Kimjw2024/2026ESWContest_free_AEGIS/docs/DATASET.md

# Dataset & Curation

## 1. Raw Archive vs Curated Training Data

The project uses two different scale descriptions, and they must not be mixed.

### Raw Working Archive

Recorded in the competition deck:

- approximately **13 GB**
- **156,416 files**
- **33 folders**
- approximately **40K candidate images**

This includes source images, labels, intermediate exports, logs, model artifacts and backup material.

### Curated Valid Paired Images

| Class / Group | Valid paired images |
|---|---:|
| crow | 1,674 |
| duck | 1,588 |
| egret | 2,125 |
| gull | 2,288 |
| pigeon | 1,294 |
| raptor | 1,481 |
| sparrow | 1,379 |
| swallow | 1,341 |
| **Total** | **13,170** |

`raptor` is a bird group rather than a single biological species; the correct wording is **8-class bird classification / 8개 조류군 분류**.

## 2. Curation Pipeline

```text
source image/label pairing
→ class-wise candidate review
→ duplicate / low-resolution / blur removal
→ non-bird / wrong-class exclusion
→ missing-label audit
→ manual exclusion rules
→ Raspberry Pi field-background hard negatives
→ detector split and classifier crop split
→ training / validation / held-out test
```

- Raspberry Pi field-background negatives: **518**
- Final prepared YOLO v2: **12,819 images**
- Held-out test: **1,325 images / 1,436 bird instances / 67 backgrounds**

<p align="center">class-wise dataset candidate review</p>

## 3. Detector and Classifier Data Separation

### YOLO

- full image
- bird bbox label
- background / hard-negative image
- objective: localization center for 3D tracking

### ResNet-18

- detector-derived or curated object crop
- one of 8 class/group labels
- objective: species/group evidence for risk assessment

The detector and classifier are related but do not use an identical sample representation.

## 4. Reproducibility

- preparation: `training/prepare_aegis_bird_data.py`
- audit: `training/audit_yolo_missing_birds_v2.py`
- clean build: `training/build_clean_yolo_v2.py`
- visual inspection: `training/inspect_prepared_samples.py`
- manual rules: `training/audit_rules.json`

The raw corpus is not committed because of size and source-management constraints. The repository preserves code, class definitions, summary counts, final metrics and representative evidence.

## 5. Source Provenance & Redistribution Control

The public contest repository **does not redistribute the 13 GB raw image corpus**.

For every external source batch, the team must retain an internal source ledger containing:

| Required field | Purpose |
|---|---|
| Provider / dataset name | identify the original source |
| Source URL or archive ID | trace the exact batch |
| Acquisition date | preserve version context |
| License / terms of use | verify training and redistribution conditions |
| Redistribution allowed? | decide whether raw images may be published |
| Local batch / class mapping | connect source records to curated outputs |
| Team edits | record relabeling, crop, exclusion and hard-negative processing |

Public repository 관리 원칙:

- non-self-captured external batch는 source와 usage condition을 확인 대상으로 관리한다
- do not upload raw images whose redistribution permission is unclear
- keep source-specific records in the Master Archive if they contain local paths or non-public acquisition metadata
- cite public datasets/providers in the report or repository when their terms require attribution

공개 저장소에는 재현 코드·정제 규칙·집계 결과와 대표 evidence를 제공하고, 원천별 상세 기록은 재배포 조건과 로컬 경로 노출을 고려해 별도 관리한다.

## 6. Validation Scope

The dataset is a research/competition prototype and does not fully represent every airport, weather, altitude, sensor and background distribution. Offline metrics must not be presented as certified field performance.
