Kimjw2024/2026ESWContest_free_AEGIS/assets/ai_console/decision_console.png

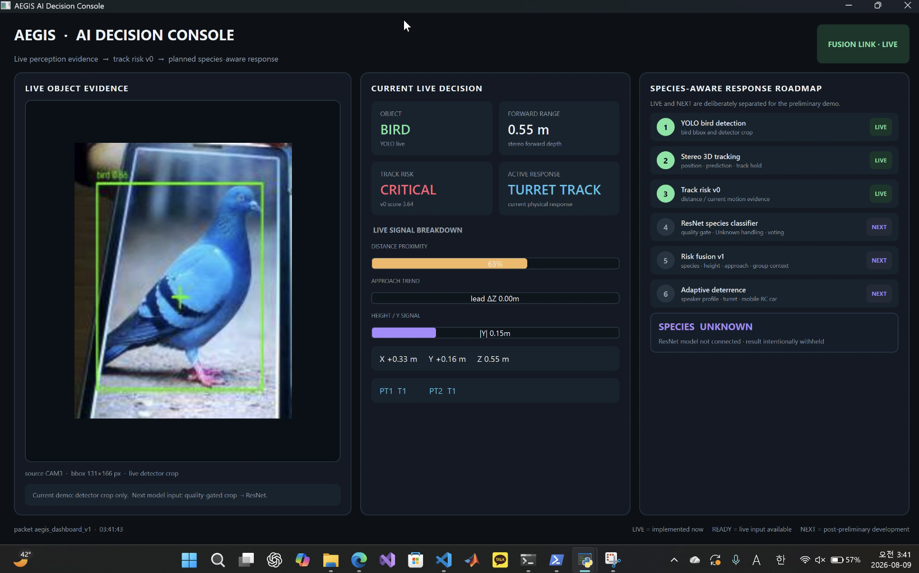
assets/ai_console/decision_console.png
