Kimjw2024/2026ESWContest_free_AEGIS/assets/dataset/dataset_management.png

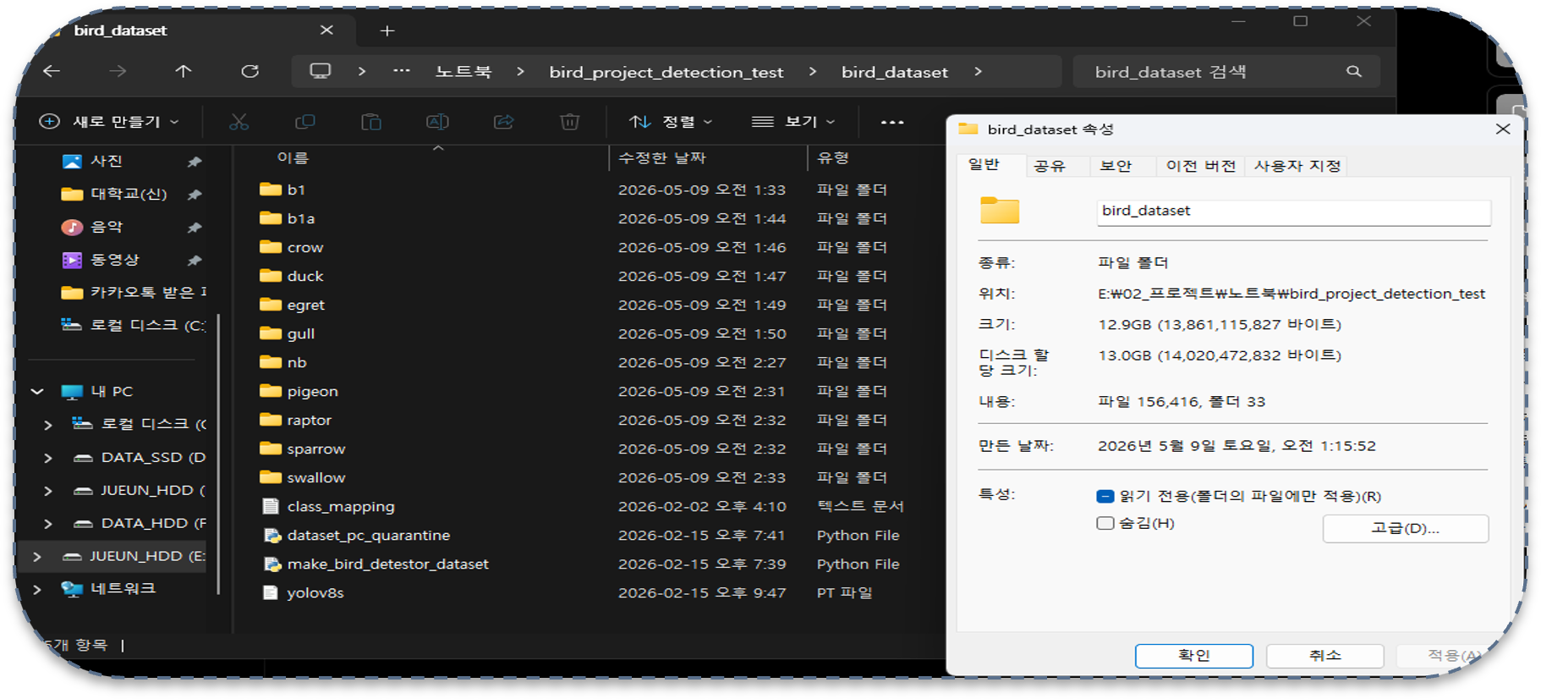
assets/dataset/dataset_management.png
