Kimjw2024/2026ESWContest_free_AEGIS/assets/system/hsv_baseline.png

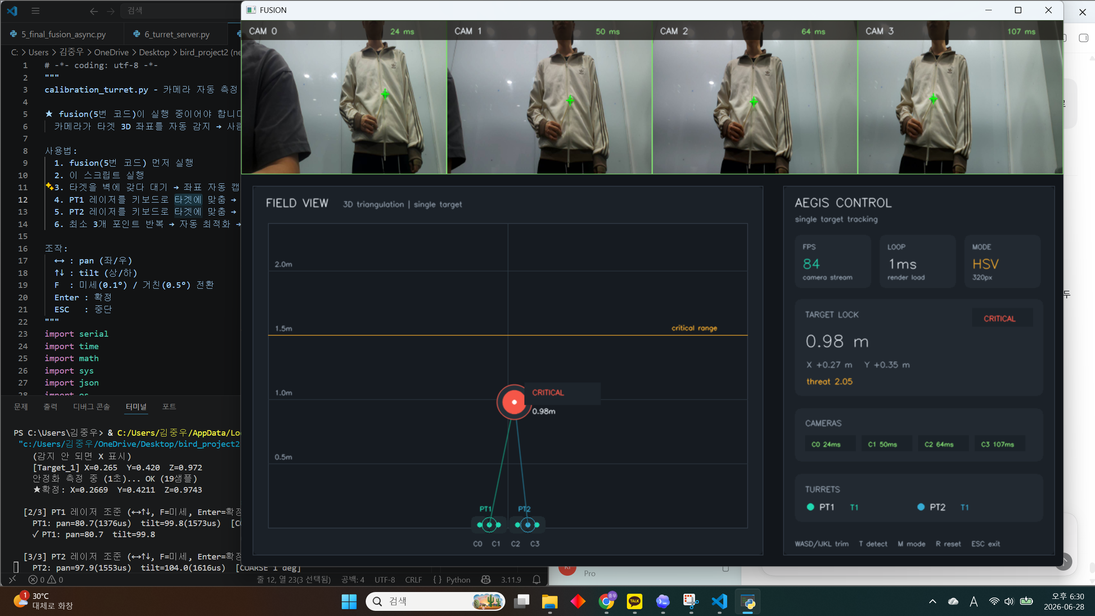
assets/system/hsv_baseline.png
