Kimjw2024/2026ESWContest_free_AEGIS/results/yolo/results.csv

epoch | time | train/box_loss | train/cls_loss | train/dfl_loss | metrics/precision(B) | metrics/recall(B) | metrics/mAP50(B) | metrics/mAP50-95(B) | val/box_loss | val/cls_loss | val/dfl_loss | lr/pg0 | lr/pg1 | lr/pg2
1 | 1414.18 | 1.61483 | 1.60596 | 1.93497 | 0.66806 | 0.63314 | 0.67292 | 0.31463 | 1.66369 | 2.003 | 2.14464 | 0.000666406 | 0.000666406 | 0.000666406
2 | 2832.3 | 1.55933 | 1.61205 | 1.886 | 0.78789 | 0.6524 | 0.76111 | 0.3734 | 1.6604 | 1.58159 | 2.0837 | 0.00131108 | 0.00131108 | 0.00131108
3 | 4272.09 | 1.50686 | 1.53948 | 1.83385 | 0.84123 | 0.73549 | 0.83377 | 0.42467 | 1.59404 | 1.35214 | 2.01122 | 0.00193375 | 0.00193375 | 0.00193375
4 | 5711.69 | 1.45627 | 1.43136 | 1.79053 | 0.88391 | 0.80312 | 0.88133 | 0.48733 | 1.49116 | 1.17916 | 1.9015 | 0.001901 | 0.001901 | 0.001901
5 | 7150.94 | 1.4215 | 1.35807 | 1.75898 | 0.87318 | 0.78612 | 0.87957 | 0.51673 | 1.37643 | 1.07925 | 1.79633 | 0.001868 | 0.001868 | 0.001868
6 | 8590.66 | 1.3756 | 1.30577 | 1.72758 | 0.903 | 0.83076 | 0.90859 | 0.5437 | 1.37522 | 0.93113 | 1.77099 | 0.001835 | 0.001835 | 0.001835
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
