Kimjw2024/2026ESWContest_free_AEGIS/results/yolo/confusion_matrix.png

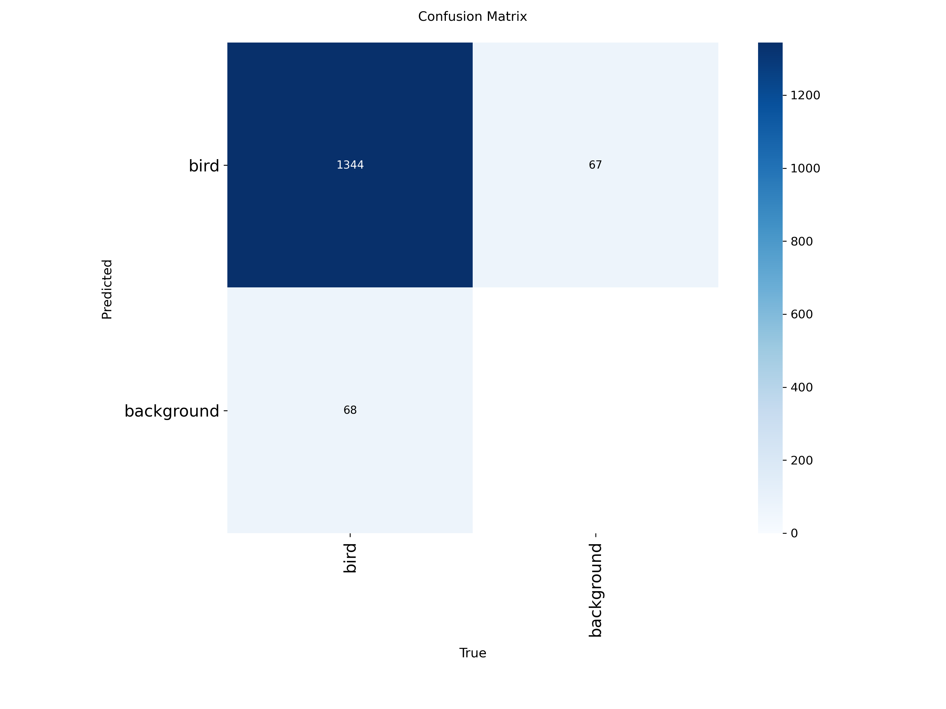
results/yolo/confusion_matrix.png
