Kimjw2024/2026ESWContest_free_AEGIS/results/yolo/labels.jpg

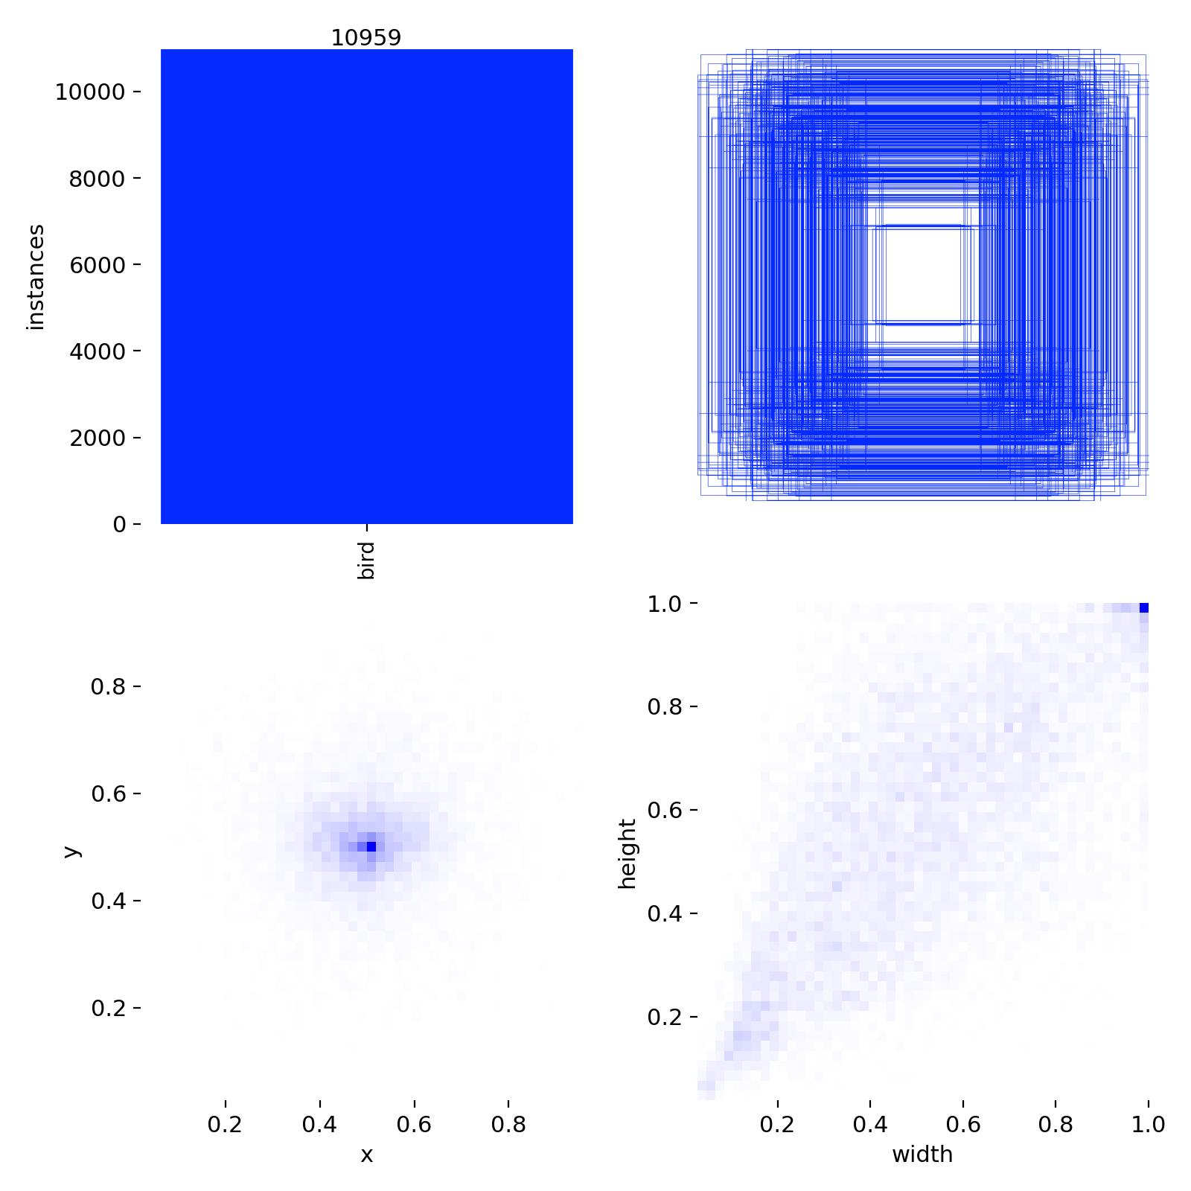
results/yolo/labels.jpg
