Kimjw2024/2026ESWContest_free_AEGIS/(commit log)

2026-08-29 feat: publish AEGIS 2026 Embedded SW Contest submission
    [history.csv, results.csv]
2026-08-29 docs: index operation flow and detailed file structure
2026-08-29 docs: expand operation flow, environment, and file architecture
2026-09-01 runtime: add direction-aware turret backlash compensation
    [6_turret_server.py]
2026-09-01 docs: document final 20-point turret recalibration and backlash tuning
2026-09-01 docs: record final 2-RPi LAN runtime and calibration path
2026-09-01 docs: update runbook for final 2-RPi integration and turret calibration
2026-09-01 docs: sync operation flow with final turret control path
2026-09-01 docs: update documentation index for final turret calibration
2026-09-01 runtime: sync final 20-point turret calibration override
2026-09-01 runtime: sync final 20-point turret calibration samples
2026-09-01 Stabilize YOLO aiming inputs
    [config_turret.py]
2026-09-01 Hold last stereo aim on YOLO mono frames
2026-09-01 Clamp instead of pausing large YOLO moves
2026-09-01 Revert turret motion tuning
    [config_turret.py]
2026-09-01 Keep YOLO camera centers synchronized during fast motion
2026-09-02 assets: add HSV dual-turret aiming evidence
    Add the annotated full-system HSV 3D tracking frame showing both lasers aligned to the controlled target.
2026-09-02 docs: frame detector roles for final review
    Updated the interpretation of results in AI_RESULTS.md to clarify the roles of Custom YOLOv8s and live Runtime.
