Kimjw2024/2026ESWContest_free_AEGIS/assets/hardware/rc_car_acoustic_prototype.jpg

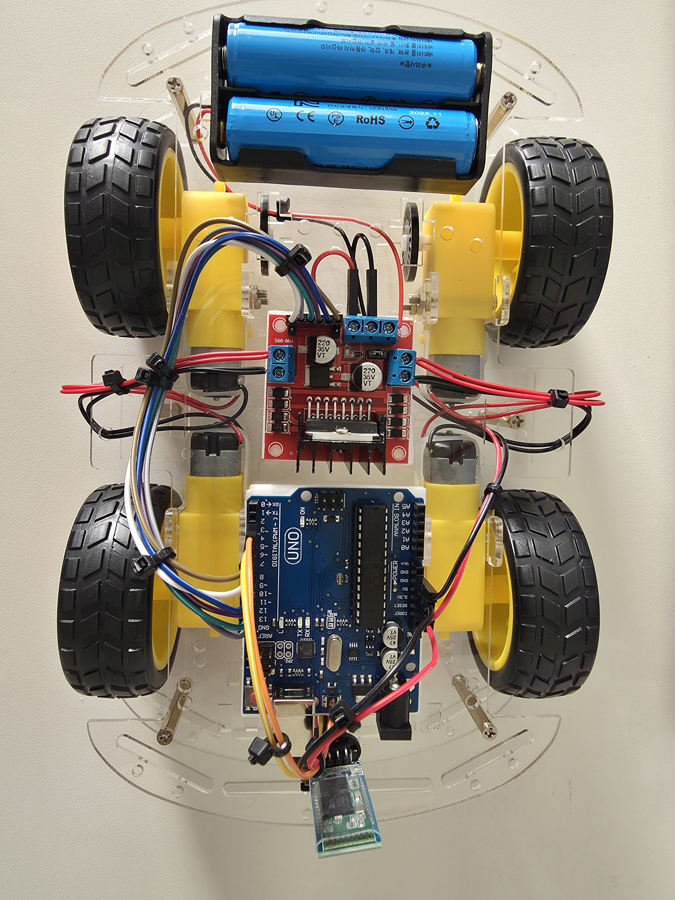
assets/hardware/rc_car_acoustic_prototype.jpg
